Boden-Research/Traffic-Light-Clock/docs/TrafficClockLayout.png

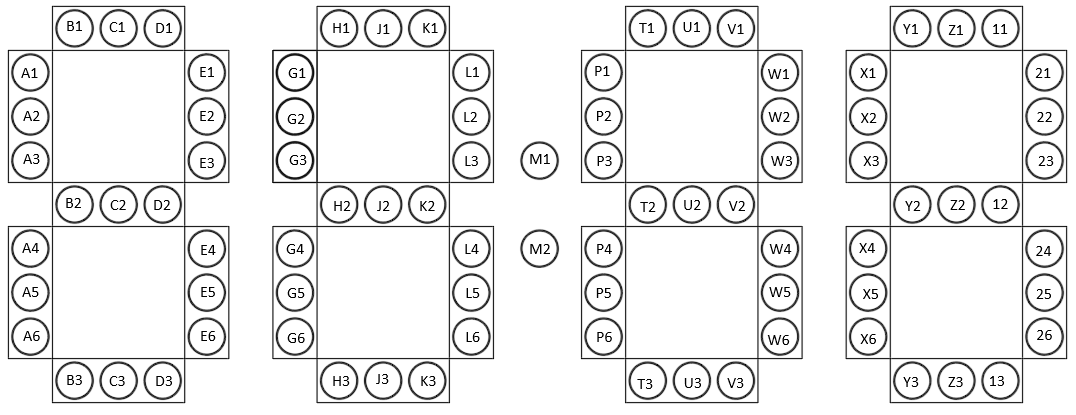
docs/TrafficClockLayout.png
