Boden-Research/Traffic-Light-Clock/docs/Traffic Light Clock Signals - Signal Audit.pdf

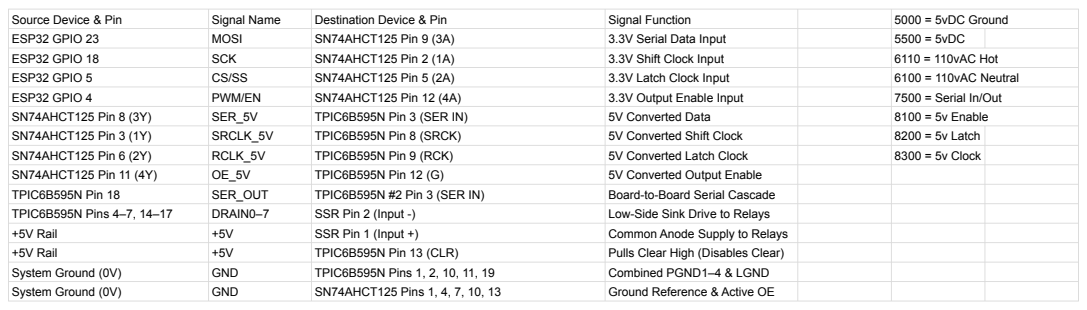
[picture p2: page 1]
Source Device & Pin; Signal Name; Destination Device & Pin; Signal Function; 5000 = 5vDC Ground; ESP32 GPIO 23; MOSI; SN74AHCT125 Pin 9 (3A); 3.3V Serial Data Input; 5500 = 5vDC; ESP32 GPIO 18; SCK; SN74AHCT125 Pin 2 (1A); 3.3V Shift Clock Input; 6110 = 110vAC Hot; ESP32 GPIO 5; SN74AHCT125 Pin 5 (2A); 3.3V Latch Clock Input; 6100 = 110vAC Neutral; ESP32 GPIO 4; PWM/EN; SN74AHCT125 Pin 12 (4A); 3.3V Output Enable Input; 7500 = Serial In/Out; SN74AHCT125 Pin 8 (3Y); SER_5V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
