Boden-Research/Traffic-Light-Clock/hardware/RelayBoard/TrafficLight_RelayModule.kicad_pcb

## KiCad design hardware/RelayBoard/TrafficLight_RelayModule.kicad_pcb (2026-08-17)

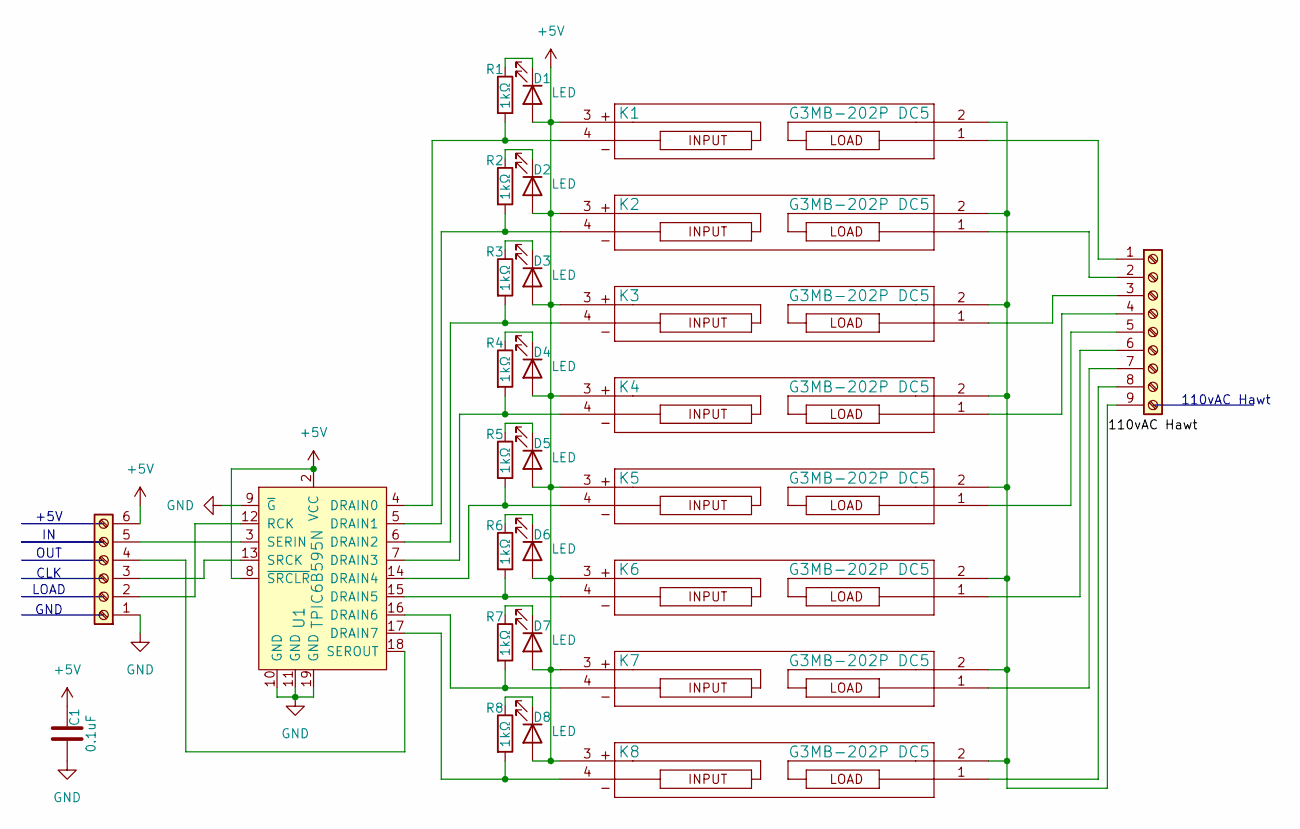
[picture p3: schematic TrafficLight_RelayModule.kicad_sch]

Parts:
C1: 0.1uF; C_0805_2012Metric
D1, D2, D3, D4, D5, D6, D7, D8: LED; LED_0805_2012Metric
J1: Screw_Terminal_01x09; TerminalBlock_MaiXu_MX126-5.0-09P_1x09_P5.00mm
J2: Screw_Terminal_01x06; TerminalBlock_MaiXu_MX126-5.0-06P_1x06_P5.00mm
K1, K2, K3, K4, K5, K6, K7, K8: G3MB-202P DC5; G3MB_202P_DC5
R1, R2, R3, R4, R5, R6, R7, R8: 1kΩ; R_0805_2012Metric
U1: TPIC6B595N; MPN TPIC6B595N; Digi-Key_PN 296-1956-5-ND

Connections:
+5V: C1.1, D1.2 (A), D2.2 (A), D3.2 (A), D4.2 (A), D5.2 (A), D6.2 (A), D7.2 (A), D8.2 (A), J2.6, K1.3, K2.3, K3.3, K4.3, K5.3, K6.3, K7.3, K8.3, U1.2 (VCC), U1.8 (~SRCLR)
/110vAC Hawt: J1.9, K1.2, K2.2, K3.2, K4.2, K5.2, K6.2, K7.2, K8.2
GND: C1.2, J2.1, U1.9 (~G), U1.10 (GND), U1.11 (GND), U1.19 (GND)
unnamed: D1.1 (K), R1.1
unnamed: D2.1 (K), R2.1
unnamed: D3.1 (K), R3.1
unnamed: D4.1 (K), R4.1
unnamed: D5.1 (K), R5.1
unnamed: D6.1 (K), R6.1
unnamed: D7.1 (K), R7.1
unnamed: D8.1 (K), R8.1
unnamed: J1.1, K1.1
unnamed: J1.2, K2.1
unnamed: J1.3, K3.1
unnamed: J1.4, K4.1
unnamed: J1.5, K5.1
unnamed: J1.6, K6.1
unnamed: J1.7, K7.1
unnamed: J1.8, K8.1
unnamed: J2.2, U1.12 (RCK)
unnamed: J2.3, U1.13 (SRCK)
unnamed: J2.4, U1.18 (SEROUT)
unnamed: J2.5, U1.3 (SERIN)
unnamed: K1.4, R1.2, U1.4 (DRAIN0)
unnamed: K2.4, R2.2, U1.5 (DRAIN1)
unnamed: K3.4, R3.2, U1.6 (DRAIN2)
unnamed: K4.4, R4.2, U1.7 (DRAIN3)
unnamed: K5.4, R5.2, U1.14 (DRAIN4)
unnamed: K6.4, R6.2, U1.15 (DRAIN5)
unnamed: K7.4, R7.2, U1.16 (DRAIN6)
unnamed: K8.4, R8.2, U1.17 (DRAIN7)

Notes on the sheet:
OUT
LOAD
CLK
110vAC Hawt
GND
+5V

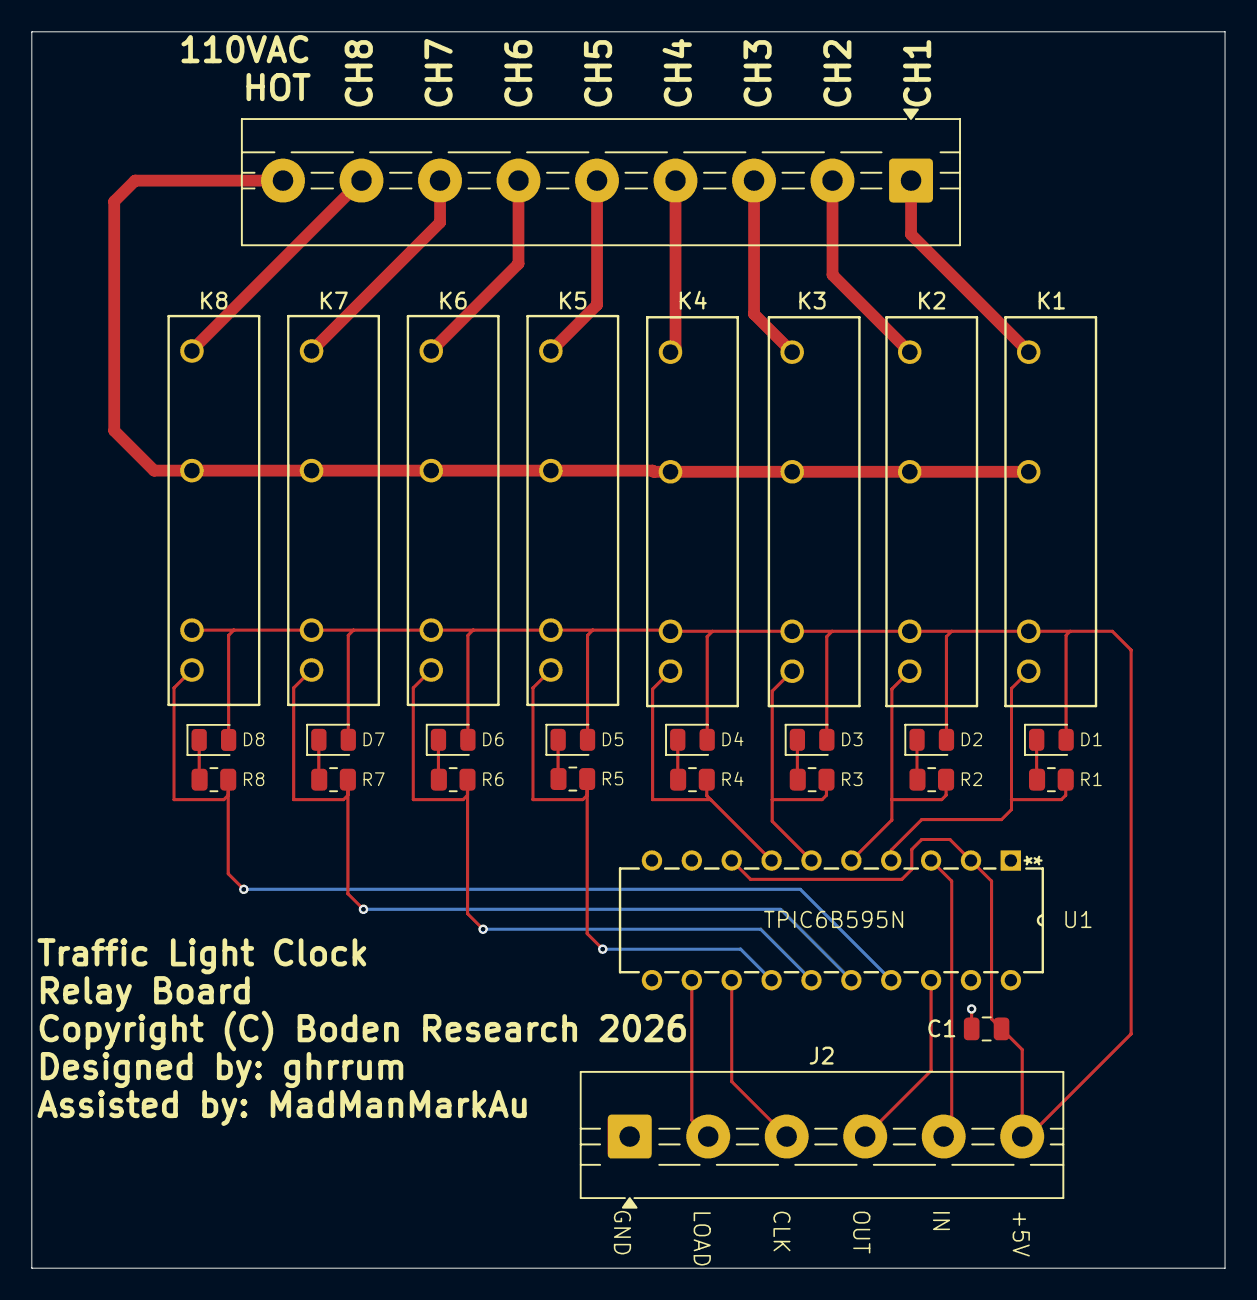
[picture p4: board TrafficLight_RelayModule.kicad_pcb from above]

Board: 2 copper layers, 76.0 x 78.8 mm, 28 parts (0 on the bottom side), 31 nets.
