Boden-Research/Traffic-Light-Clock/docs/Wiring Legend.txt

5000 = 5vDC Ground
5500 = 5vDC
6110 = 110vAC Hot
6100 = 110vAC Neutral
7500 = Serial In/Out
8100 = 5v Enable
8200 = 5v Latch
8300 = 5v Clock
9000 = SSR 110v Hot Output to Light
