Boden-Research/Traffic-Light-Clock/(commit log)

2026-08-08 Updates on Cabinet
    [110Block.kicad_sch, 2_ControlBoard.kicad_sch, 5000Block.kicad_sch, 5500Block.kicad_sch, 6110Block.kicad_sch, ElectricalCabinet.kicad_sch, TrafficLight.kicad_sch]
2026-08-09 Cabinet Schematics Update
    [2_ControlBoard.kicad_sch, 5000Block.kicad_sch, 8100Block.kicad_sch, 8200Block.kicad_sch, 8300Block.kicad_sch, RelayBoard1.kicad_sch, TrafficLight.kicad_sch, TrafficLight_RelayModule.kicad_sch]
2026-08-09 More updates
    Added drawing sheets, wire label scheme, signal list, and traffic light label image to docs folder
    [2_ControlBoard.kicad_sch, 5000Block.kicad_sch, 5500Block.kicad_sch, 8300Block.kicad_sch, ElectricalCabinet.kicad_sch, RelayBoard1.kicad_sch]
2026-08-10 Further wiring updates
    Populated 6100 Bus
    Corrected number of relay boards
    Added 110v outputs to relay boards and noted light positon
    Uploaded light scheme to documents folder
    [2_ControlBoard.kicad_sch, 5000Block.kicad_sch, 5500Block.kicad_sch, 6100Block.kicad_sch, 6110Block.kicad_sch, 8200Block.kicad_sch, 8300Block.kicad_sch, ElectricalCabinet.kicad_sch]
2026-08-10 Schematic Update
    Electrical Cabinet schematic done, this will be the last update unless something else needs to be changed.
    [5500Block.kicad_sch, RelayBoard2.kicad_sch]
2026-08-10 Electrical Cabinet done
    Electrical Cabinet done, let me know if there are any changes or mistakes.
    [2_ControlBoard.kicad_sch, 5000Block.kicad_sch, 5500Block.kicad_sch, 8200Block.kicad_sch, 8300Block.kicad_sch, ElectricalCabinet.kicad_sch, RelayBoard1.kicad_sch, RelayBoard10.kicad_sch]
2026-08-16 Updates to electrical board after review
    [TrafficLight_RelayModule.kicad_pcb, TrafficLight_RelayModule.kicad_sch]
2026-10-11 Fix log msgs, implement basic light driver
2026-10-17 Added test/dev board for testing firmware
2026-10-25 Animation interface finished. Editor implemented. Added some sample animations.
