Boden-Research/Traffic-Light-Clock/(notices)

Notices in the files:
hardware/RelayBoard/TrafficLight_RelayModule.kicad_pcb:
Copyright (C) Boden Research 2026
